descipar/balcon_irrigation_project/README.md

# balcon_irrigation_project
Project for a simple balcon irrigation
