descipar/balcon_irrigation_project/stl/Film_canister_47mm.stl

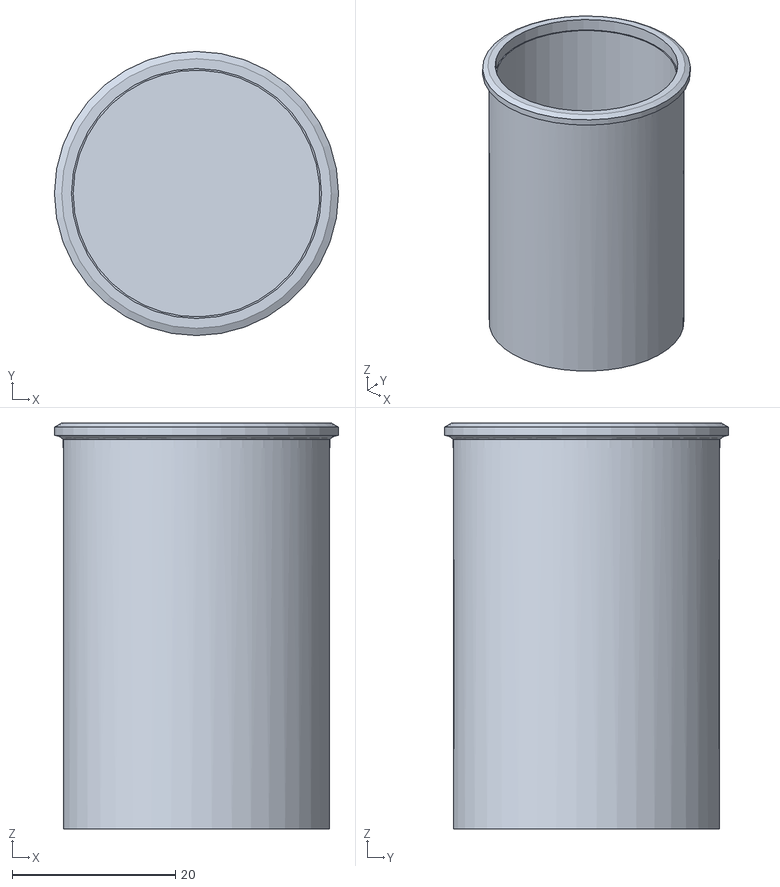
[picture p1: CAD file, 2020-09-13]
stl/Film_canister_47mm.stl
34.8 x 34.8 x 49.7
