descipar/balcon_irrigation_project/stl/WaterDistributor.stl

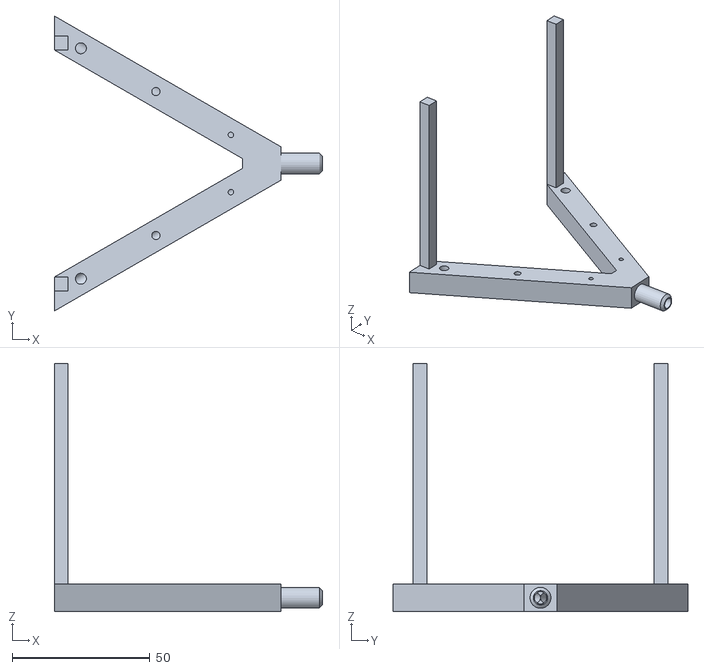
[picture p2: CAD file, 2020-09-13]
stl/WaterDistributor.stl
97.3 x 107.0 x 90.0
