descipar/balcon_irrigation_project/stl/Film_cap.stl

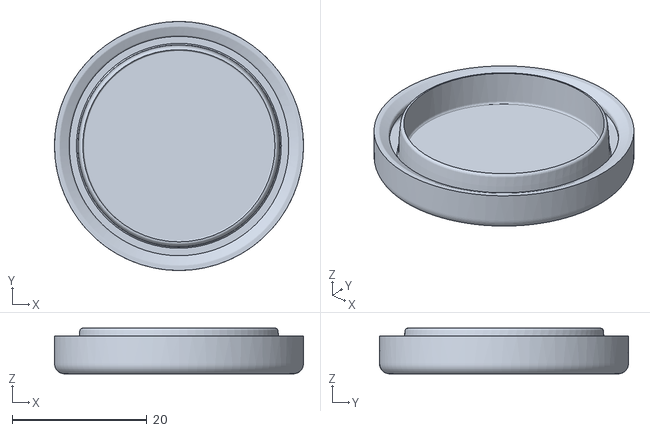
[picture p3: CAD file, 2020-09-13]
stl/Film_cap.stl
37.0 x 37.0 x 6.78
