descipar/balcon_irrigation_project/stl/Film_canister_20mm.stl

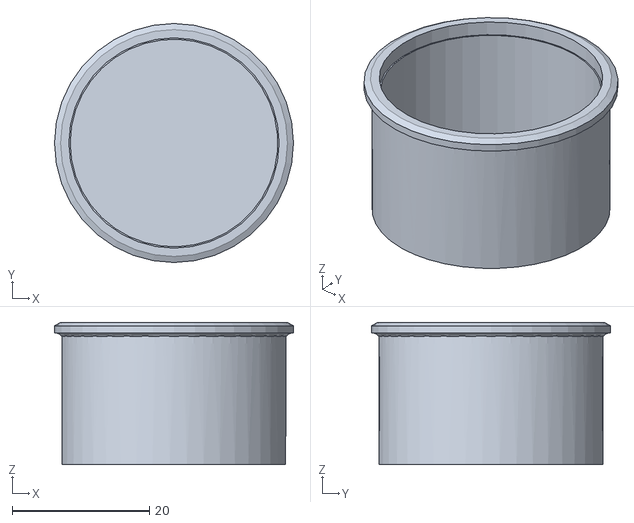
[picture p4: CAD file, 2020-09-13]
stl/Film_canister_20mm.stl
34.8 x 34.8 x 20.7
