descipar/balcon_irrigation_project/stl/Film_canister_12mm.stl

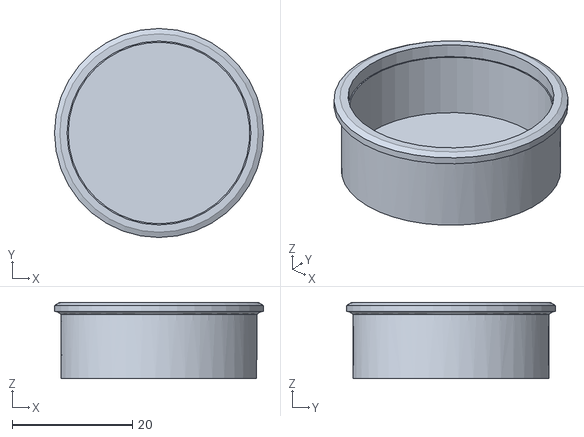
[picture p5: CAD file, 2020-09-13]
stl/Film_canister_12mm.stl
34.8 x 34.8 x 12.7
