descipar/balcon_irrigation_project/hardware/v2/kicad/balcon_irrigation_v2.pdf

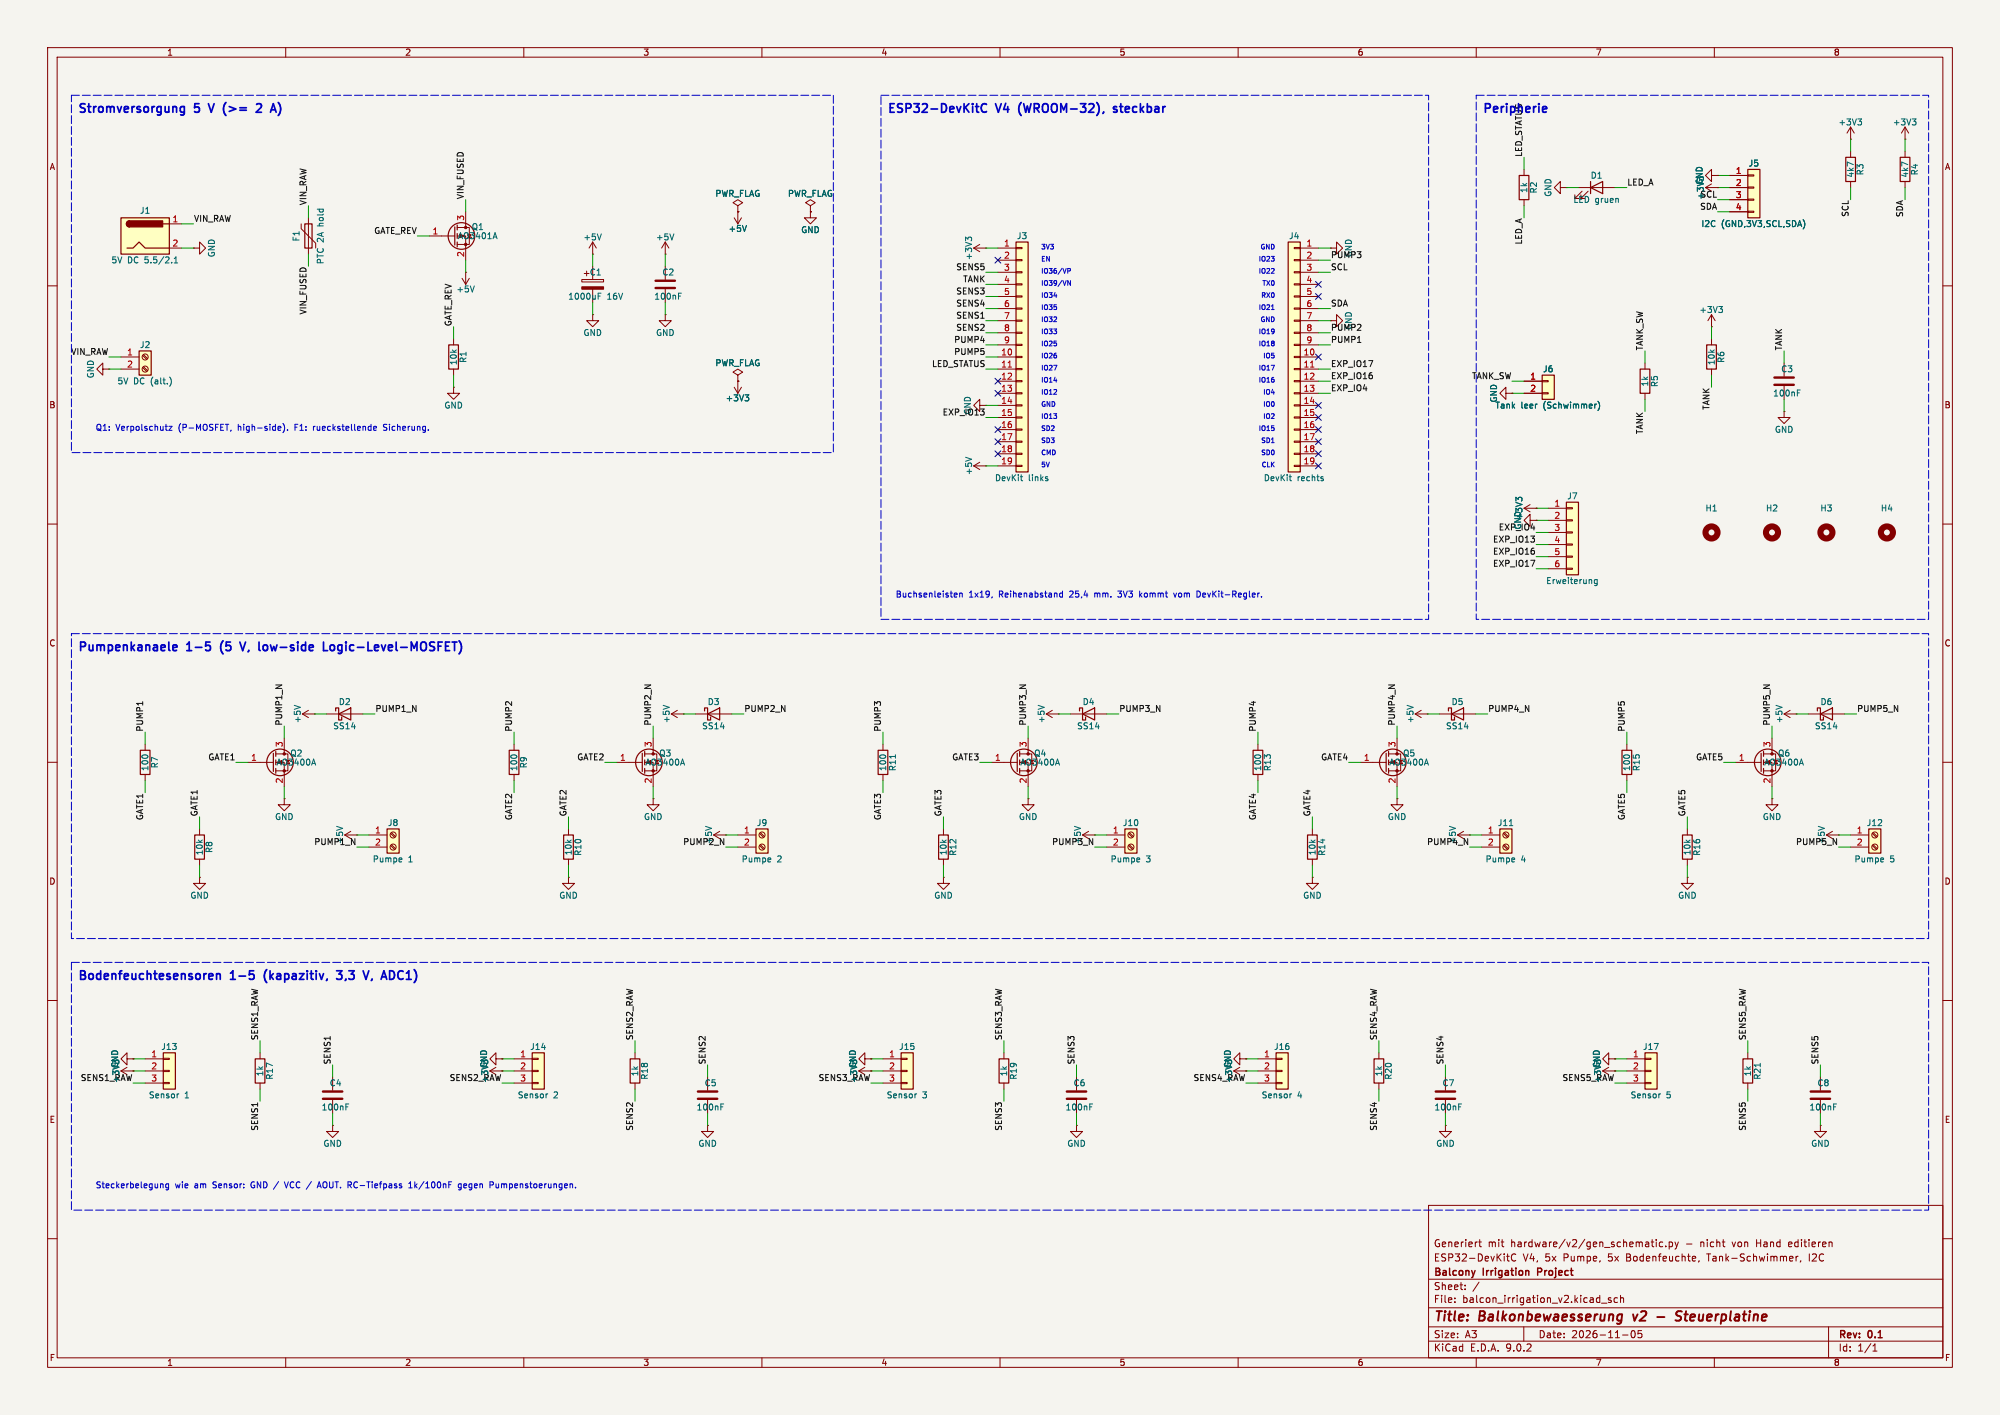
[picture p6: page 1]

LED gruen GND GND +5V
