descipar/balcon_irrigation_project/hardware/v2/kicad/balcon_irrigation_v2_bottom.pdf

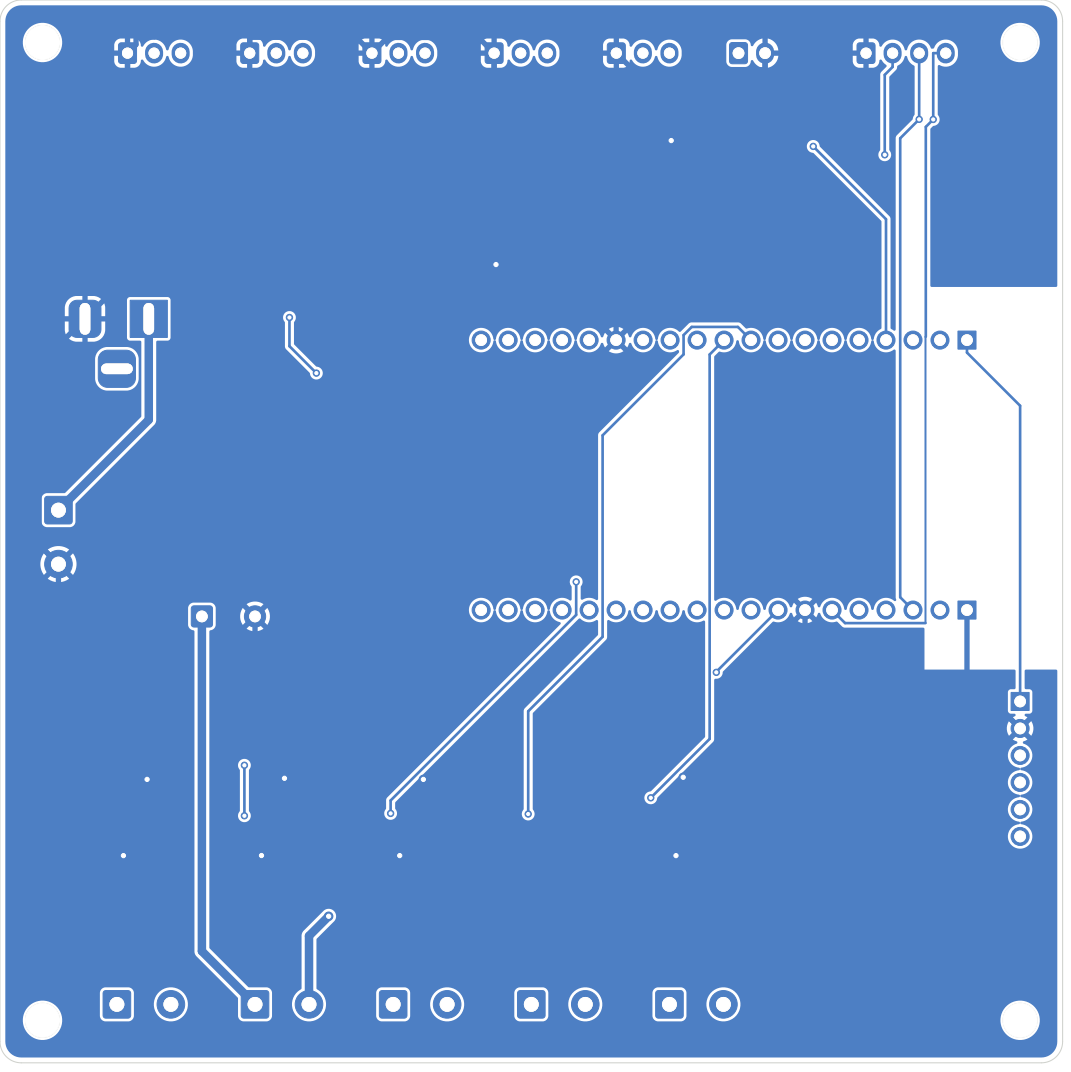
[picture p7: page 1]
