descipar/balcon_irrigation_project/hardware/v2/kicad/balcon_irrigation_v2_top.pdf

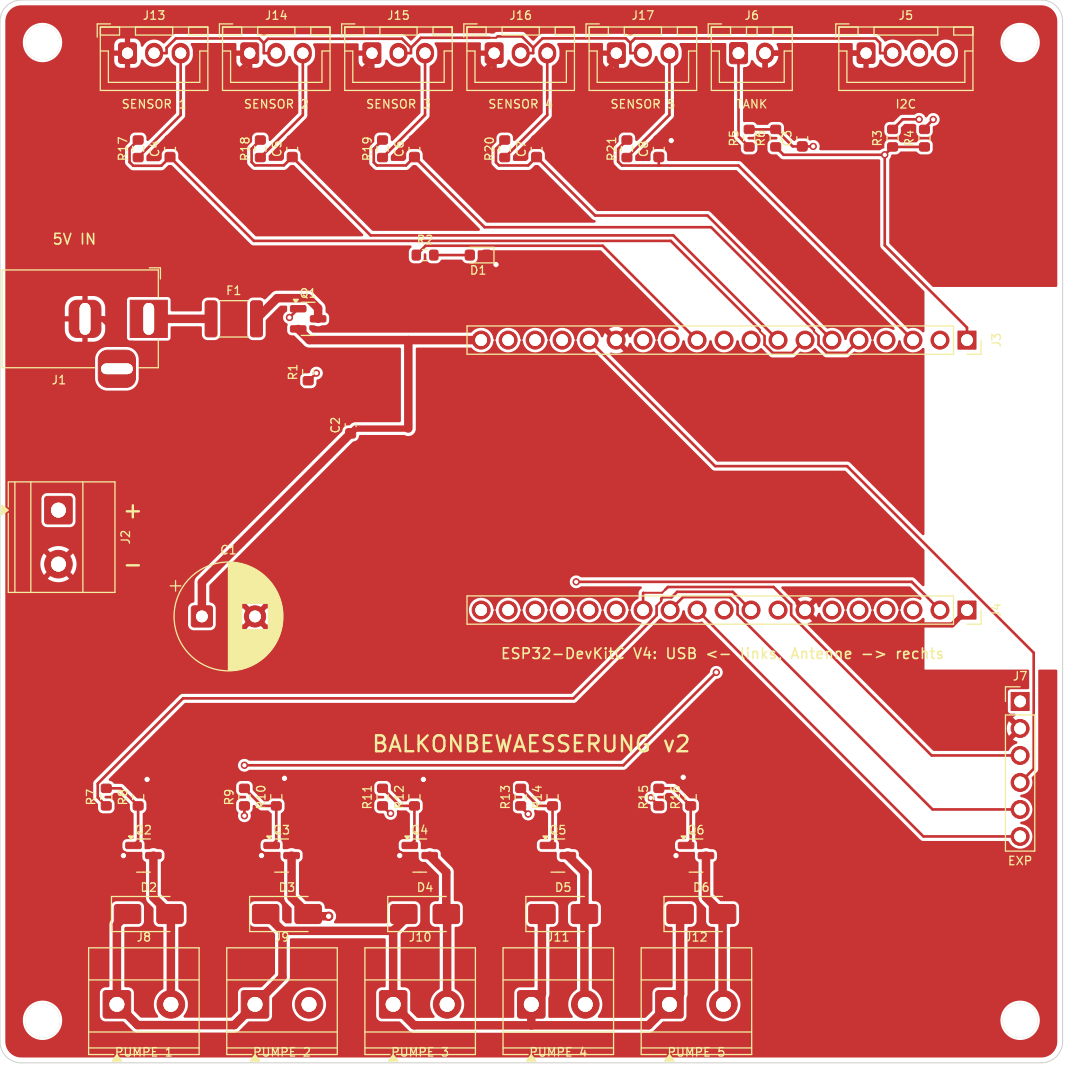
[picture p8: page 1]
