descipar/balcon_irrigation_project/(list of files, drawings)

Other design files:
fritzing_workspace/balcon_irrigation_circuits.fzz
