descipar/balcon_irrigation_project/(commit log)

2020-09-13 breadboard complete
    [balcon_irrigation_circuits.fzz]
2020-09-13 +
    first try
    [Film_canister_12mm.stl]
2020-09-13 another canister
    [Film_canister_20mm.stl]
2020-09-13 missing stls
    [Film_canister_47mm.stl, Film_cap.stl, WaterDistributor.stl]
2020-09-28 not working with not enough waiting time
    [main.cpp]
2020-09-30 pumping time back to 3000
2020-10-10 testing for sensor values
2026-11-05 Document v1 analysis and v2 ESP32/PCB plan
    - README: project overview, repo structure, v1 usage, v2 roadmap
    - docs/v1-analysis.md: bugs and weaknesses of the Arduino Uno version
    - docs/v2-hardware.md: ESP32 concept, MOSFET pump driver, power, pinout
    - docs/v2-pcb.md: JLCPCB-assembled PCB plan and KiCad toolchain on serviceplasma
2026-11-05 Add generated KiCad schematic for v2 controller board
    - hardware/v2/gen_schematic.py generates the KiCad 9 schematic
    (deterministic output, ERC clean)
    - ESP32-DevKitC V4 on sockets, 5 MOSFET pump channels, 5 filtered
    sensor inputs, tank float input, I2C, status LED, expansion header,
    reverse-polarity protection and PTC fuse on the 5V input
    - Pumps moved to GPIO 18/19/23/25/26 (16/17 are PSRAM on WROVER)
    - PDF export for viewing without KiCad
2026-11-05 Add autorouted PCB layout for v2 controller board
    - hardware/v2/gen_layout.py builds the board from the schematic netlist:
    footprint placement, 100x100 mm outline, silkscreen, antenna keepout,
    Freerouting autoroute, GND pours on both layers after routing
    - Net classes: Power 0.8 mm, Ground 0.5 mm, Default 0.25 mm
    - DRC: 0 errors, 0 unconnected pads (only silkscreen overlaps left)
    - Mounting holes excluded from BOM in the schematic
